adamjvr/kimchi-ethernet-lid/README.md

# kimchi-ethernet-lid
A simple lid for the GroupGets Kimchi Miro SBC that adds gigabit Ethernet in a compact package
