adamjvr/kimchi-ethernet-lid/PCB/NewOrderBom.ods

Reference | Quantity | MFR# | Digikey # | Notes
C16 | 1 | GRM155R61A475MEAAD | 490-14306-1-ND
C17 C18 | 2 | 04025A180GAT2A | 478-11762-1-ND
C21 | 1 | C0603C103KARACAUTO | 399-17960-1-ND
C1 C2 C3 C4 C5 C6 C7 C8 C10 C11 C12 C13 C14 C19 C20 | 15 | C0402C104K9PACTU | 399-3026-6-ND
C9 C15 | 2 | 0402ZD105KAT2A | 478-4596-1-ND
FB1 FB2 FB3 | 3 | MMZ1005S601CTD25 | 445-172793-1-ND
FB4 | 1 | FBMJ1608HM180NTR | 587-3251-1-ND
H1 H2 H3 H4 | 4 | Mechanical_MountingHole_Pad
J1 J2 | 2 | DF40HC(3.5)-60DS
J3 | 1 | ARJM11C7-502-AB-ER2-T | 535-14130-1-ND
R7 R8 R9 R10 R11 R12 R21 R22 R23 R24 R25 R26 | 12 | RC0402FR-0722RL | 311-22.0LRTR-ND
R1 R2 R3 R4 R15 R16 R20 R27 R28 | 9 | RC0402FR-071KL | 311-1.00KLRTR-ND
R5 R6 R13 R14 R17 R19 | 6 | RC0402FR-0710KL | 311-10.0KLRCT-ND
R18 | 1 | RMCF0402FT12K1 | RMCF0402FT12K1CT-ND
U1 | 1 | 24C32
U2 | 1 | TLV75712PDBVR | 296-50412-1-ND
U3 | 1 | KSZ9031RNXCC | KSZ9031RNXCC-ND | Out of Stock at Digikey, we went with this PHY because its proven in other designs our engineering team is familiar with
Y1 | 1 | ABM3-25.000MHZ-D2Y-T | 535-10645-1-ND
