adamjvr/kimchi-ethernet-lid/PCB/kimchi-ethernet-lid.kicad_pcb

## KiCad design PCB/kimchi-ethernet-lid.kicad_pcb (2021-06-15)

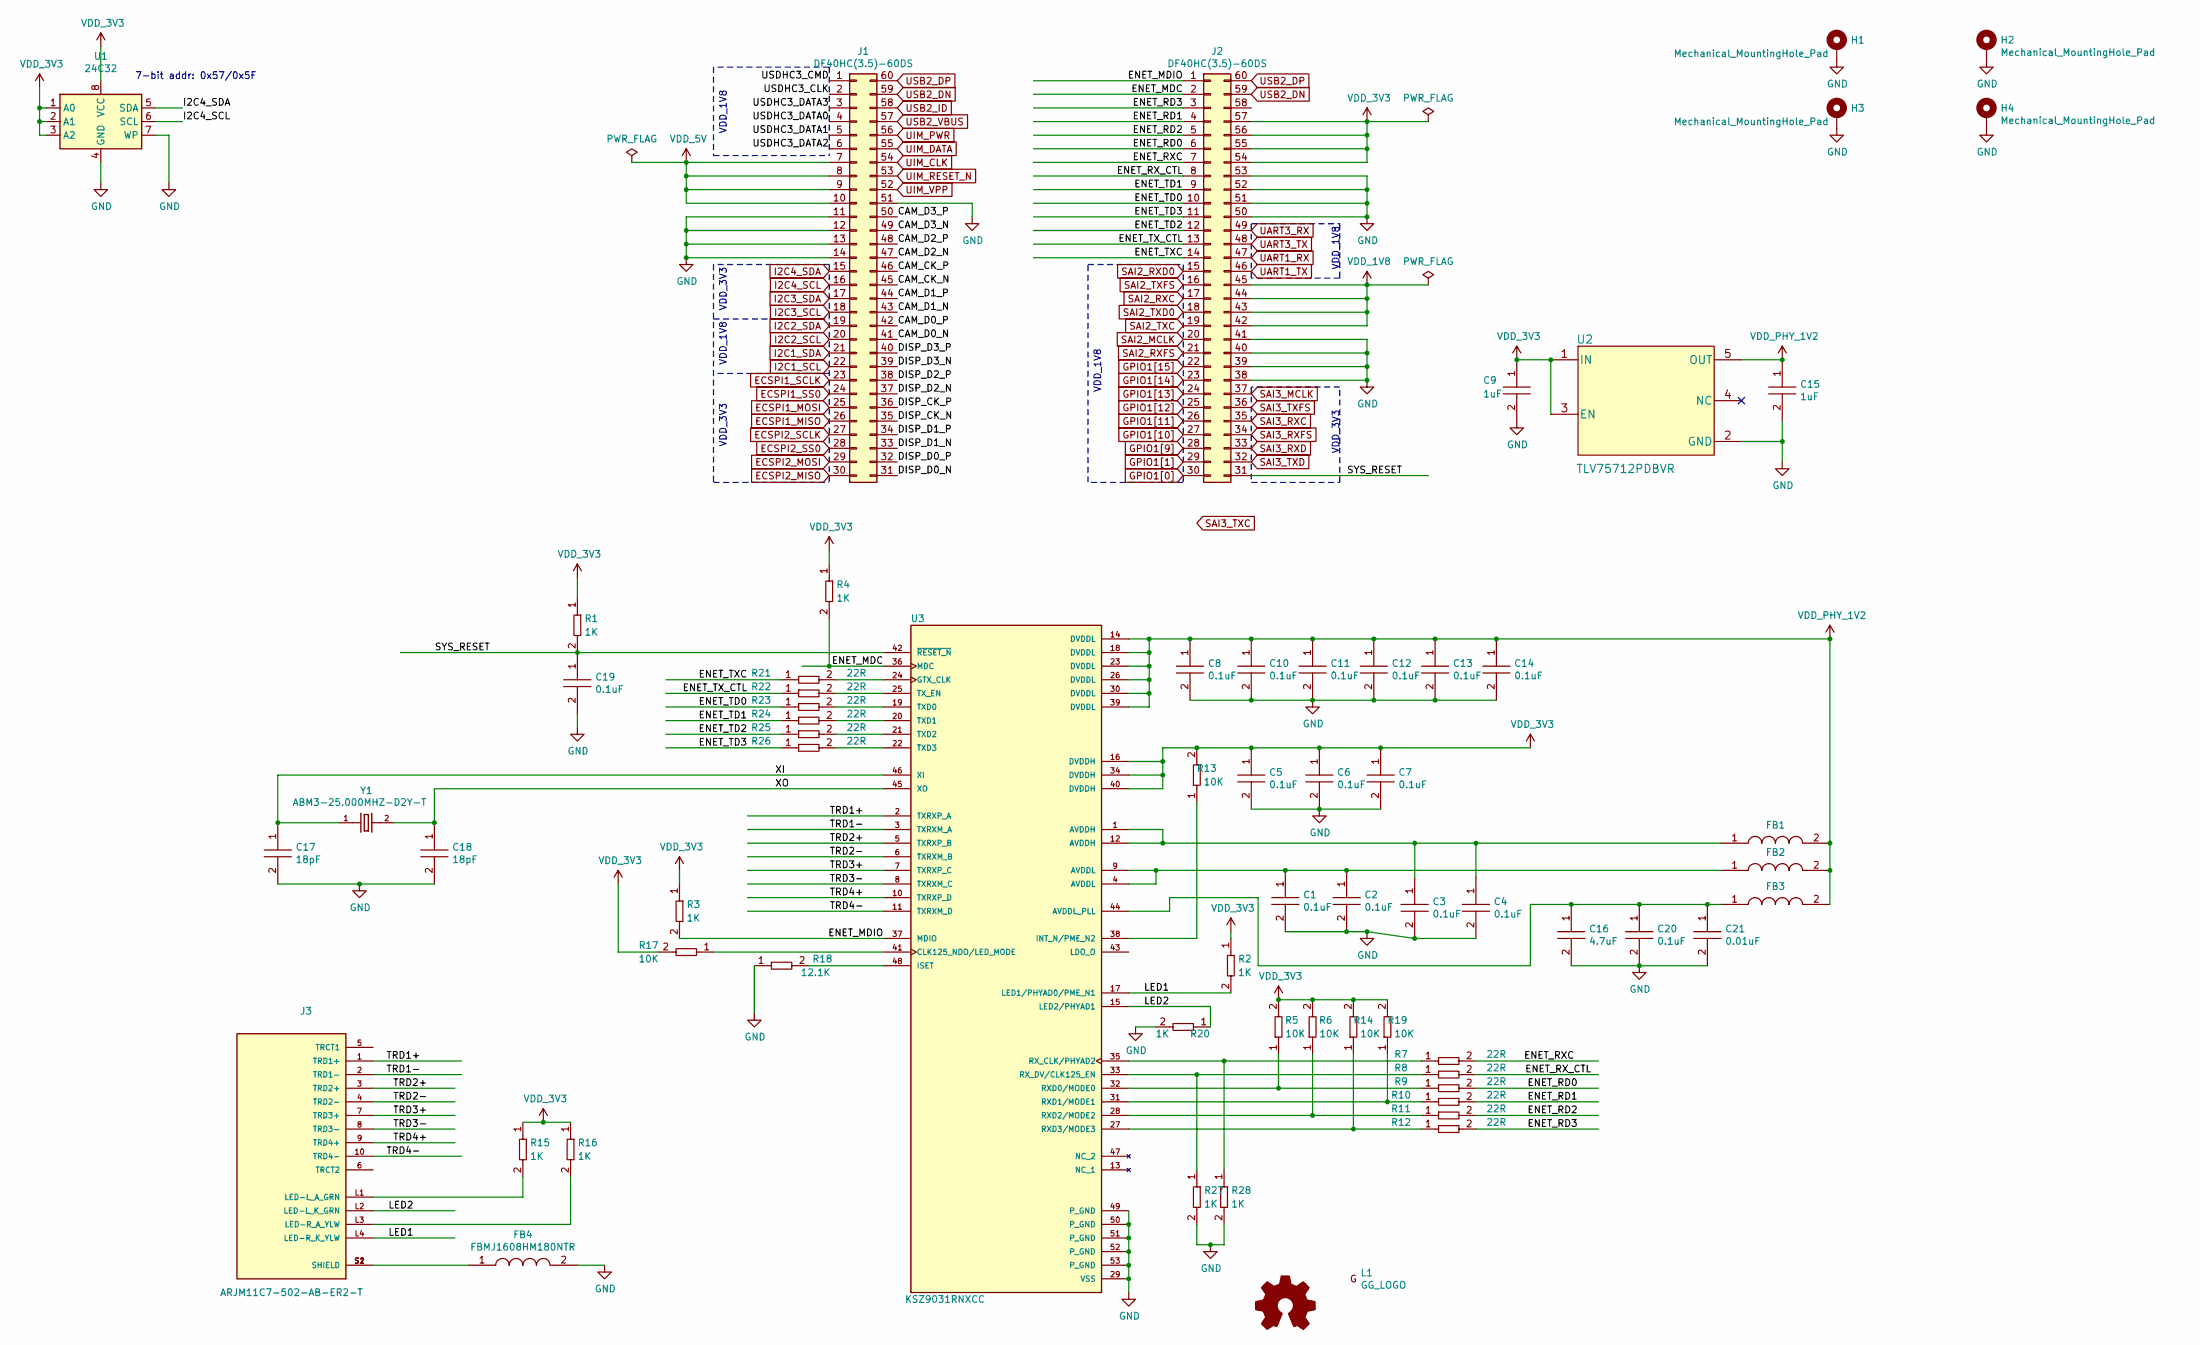
[picture p2: schematic kimchi-ethernet-lid.sch]

Parts:
C1, C2, C3, C4, C5, C6, C7, C8, C10, C11, C12, C13, C14, C19, C20: C0402C104K9PACTU; R0402; Tolerance 10%; Voltage 6.3V; MFR# C0402C104K9PACTU
C9, C15: 0402ZD105KAT2A; R0402; Tolerance 10%; Voltage 10V; MFR# 0402ZD105KAT2A
C16: GRM155R61A475MEAAD; C0402; Tolerance 20%; Voltage 10V; MFR# GRM155R61A475MEAAD
C17, C18: 04025A180GAT2A; C0402; Tolerance 2%; Voltage 50V; MFR# 04025A180GAT2A
C21: C0603C103KARACAUTO; C0603; Tolerance 10%; Voltage 250V; MFR# C0603C103KARACAUTO
FB1, FB2, FB3: MMZ1005S601CTD25; R0402; Tolerance *; Voltage *; MFR# MMZ1005S601CTD25
FB4: FBMJ1608HM180NTR; R0603; Tolerance *; Voltage *; MFR# FBMJ1608HM180NTR
H1, H2, H3, H4: Mechanical_MountingHole_Pad; MountingHole_3mm_Pad
J1, J2: DF40HC(3.5)-60DS
J3: ARJM11C7-502-AB-ER2-T; ABRACON_ARJM11C7-502-AB-ER2-T; PARTREV 04.22.2019
L1: GG_LOGO; groupgets_logo
LOGO1: Graphic_Logo_Open_Hardware_Small; OSHW-Logo_5.7x6mm_SilkScreen
R1, R2, R3, R4, R15, R16, R20, R27, R28: RC0402FR-071KL; R0402; Tolerance 1%; Voltage *; MFR# RC0402FR-071KL
R5, R6, R13, R14, R17, R19: RC0402FR-0710KL; R0402; Tolerance 1%; Voltage *; MFR# RC0402FR-0710KL
R7, R8, R9, R10, R11, R12, R21, R22, R23, R24, R25, R26: RC0402FR-0722RL; R0402; Tolerance 1%; Voltage *; MFR# RC0402FR-0722RL
R18: RMCF0402FT12K1; R0402; Tolerance 1%; Voltage *; MFR# RMCF0402FT12K1
U1: 24C32; DFN-8-1EP_3x2mm_P0.5mm_EP1.36x1.46mm; Part M24C32-FMC6TG
U2: TLV75712PDBVR
U3: KSZ9031RNXCC; QFN50P700X700X90-49N
Y1: ABM3-25.000MHZ-D2Y-T; XTAL500X320X130N

Connections:
/CAM_CK_N: J1.45
/CAM_CK_P: J1.46
/CAM_D0_N: J1.41
/CAM_D0_P: J1.42
/CAM_D1_N: J1.43
/CAM_D1_P: J1.44
/CAM_D2_N: J1.47
/CAM_D2_P: J1.48
/CAM_D3_N: J1.49
/CAM_D3_P: J1.50
/DISP_CK_N: J1.35
/DISP_CK_P: J1.36
/DISP_D0_N: J1.31
/DISP_D0_P: J1.32
/DISP_D1_N: J1.33
/DISP_D1_P: J1.34
/DISP_D2_N: J1.37
/DISP_D2_P: J1.38
/DISP_D3_N: J1.39
/DISP_D3_P: J1.40
/ENET_MDC: J2.2, R4.2, U3.36 (MDC)
/ENET_MDIO: J2.1, R3.2, U3.37 (MDIO); also elsewhere on the board
/ENET_RD0: J2.6, R9.2
/ENET_RD1: J2.4, R10.2
/ENET_RD2: J2.5, R11.2
/ENET_RD3: J2.3, R12.2
/ENET_RXC: J2.7, R7.2
/ENET_RX_CTL: J2.8, R8.2
/ENET_TD0: J2.10, R23.1
/ENET_TD1: J2.9, R24.1
/ENET_TD2: J2.12, R25.1
/ENET_TD3: J2.11, R26.1
/ENET_TXC: J2.14, R21.1
/ENET_TX_CTL: J2.13, R22.1
/LED1: J3.L4 (LED-R_K_YLW), R2.2, U3.17 (LED1/PHYAD0/PME_N1)
/LED2: J3.L2 (LED-L_K_GRN), R20.1, U3.15 (LED2/PHYAD1)
/SYS_RESET: C19.1, J2.31, R1.2, U3.42 (~RESET_N)
/TRD1+: J3.1 (TRD1+), U3.2 (TXRXP_A)
/TRD1-: J3.2 (TRD1-), U3.3 (TXRXM_A)
/TRD2+: J3.3 (TRD2+), U3.5 (TXRXP_B)
/TRD2-: J3.4 (TRD2-), U3.6 (TXRXM_B)
/TRD3+: J3.7 (TRD3+), U3.7 (TXRXP_C)
/TRD3-: J3.8 (TRD3-), U3.8 (TXRXM_C)
/TRD4+: J3.9 (TRD4+), U3.10 (TXRXP_D)
/TRD4-: J3.10 (TRD4-), U3.11 (TXRXM_D)
/USDHC3_CLK: J1.2
/USDHC3_CMD: J1.1
/USDHC3_DATA0: J1.4
/USDHC3_DATA1: J1.5
/USDHC3_DATA2: J1.6
/USDHC3_DATA3: J1.3
/XI: C17.1, U3.46 (XI), Y1.1
/XO: C18.1, U3.45 (XO), Y1.2
ECSPI1_MISO: J1.26
ECSPI1_MOSI: J1.25
ECSPI1_SCLK: J1.23
ECSPI1_SS0: J1.24
ECSPI2_MISO: J1.30
ECSPI2_MOSI: J1.29
ECSPI2_SCLK: J1.27
ECSPI2_SS0: J1.28
GND: C1.2, C2.2, C3.2, C4.2, C5.2, C6.2, C7.2, C8.2, C9.2, C10.2, C11.2, C12.2, C13.2, C14.2, C15.2, C16.2, C17.2, C18.2, C19.2, C20.2, C21.2, FB4.2, H1.1, H2.1, H3.1, H4.1, J1.11, J1.12, J1.13, J1.14, J1.51, J2.38, J2.39, J2.40, J2.41, J2.50, J2.51, J2.52, J2.53, R18.1, R20.2, R27.2, R28.2, U1.4 (GND), U1.7 (WP), U2.2 (GND), U3.29 (VSS), U3.49 (P_GND), U3.50 (P_GND), U3.51 (P_GND), U3.52 (P_GND), U3.53 (P_GND)
GPIO1[0]: J2.30
GPIO1[1]: J2.29
GPIO1[9]: J2.28
GPIO1[10]: J2.27
GPIO1[11]: J2.26
GPIO1[12]: J2.25
GPIO1[13]: J2.24
GPIO1[14]: J2.23
GPIO1[15]: J2.22
I2C1_SCL: J1.22
I2C1_SDA: J1.21
I2C2_SCL: J1.20
I2C2_SDA: J1.19
I2C3_SCL: J1.18
I2C3_SDA: J1.17
I2C4_SCL: J1.16, U1.6 (SCL)
I2C4_SDA: J1.15, U1.5 (SDA)
unnamed: C1.1, C2.1, FB2.1, U3.4 (AVDDL), U3.9 (AVDDL)
unnamed: C3.1, C4.1, FB1.1, U3.1 (AVDDH), U3.12 (AVDDH)
unnamed: C16.1, C20.1, C21.1, FB3.1, U3.44 (AVDDL_PLL)
unnamed: FB4.1, J3.S1 (SHIELD), J3.S2 (SHIELD)
unnamed: J3.L1 (LED-L_A_GRN), R15.2
unnamed: J3.L3 (LED-R_A_YLW), R16.2
unnamed: R5.1, R9.1, U3.32 (RXD0/MODE0)
unnamed: R10.1, R19.1, U3.31 (RXD1/MODE1)
unnamed: R6.1, R11.1, U3.28 (RXD2/MODE2)
unnamed: R12.1, R14.1, U3.27 (RXD3/MODE3)
unnamed: R13.1, U3.38 (INT_N/PME_N2)
unnamed: R17.1, U3.41 (CLK125_NDO/LED_MODE)
unnamed: R18.2, U3.48 (ISET)
unnamed: R21.2, U3.24 (GTX_CLK)
unnamed: R22.2, U3.25 (TX_EN)
unnamed: R23.2, U3.19 (TXD0)
unnamed: R24.2, U3.20 (TXD1)
unnamed: R25.2, U3.21 (TXD2)
unnamed: R26.2, U3.22 (TXD3)
unnamed: R8.1, R27.1, U3.33 (RX_DV/CLK125_EN)
unnamed: R7.1, R28.1, U3.35 (RX_CLK/PHYAD2)
SAI2_MCLK: J2.20
SAI2_RXC: J2.17
SAI2_RXD0: J2.15
SAI2_RXFS: J2.21
SAI2_TXC: J2.19
SAI2_TXD0: J2.18
SAI2_TXFS: J2.16
SAI3_MCLK: J2.37
SAI3_RXC: J2.35
SAI3_RXD: J2.33
SAI3_RXFS: J2.34
SAI3_TXD: J2.32
SAI3_TXFS: J2.36
UART1_RX: J2.47
UART1_TX: J2.46
UART3_RX: J2.49
UART3_TX: J2.48
UIM_CLK: J1.54
UIM_DATA: J1.55
UIM_PWR: J1.56
UIM_RESET_N: J1.53
UIM_VPP: J1.52
USB2_DN: J1.59, J2.59
USB2_DP: J1.60, J2.60
USB2_ID: J1.58
USB2_VBUS: J1.57
VDD_1V8: J2.42, J2.43, J2.44, J2.45
VDD_3V3: C5.1, C6.1, C7.1, C9.1, J2.54, J2.55, J2.56, J2.57, R1.1, R2.1, R3.1, R4.1, R5.2, R6.2, R13.2, R14.2, R15.1, R16.1, R17.2, R19.2, U1.1 (A0), U1.2 (A1), U1.3 (A2), U1.8 (VCC), U2.1 (IN), U2.3 (EN), U3.16 (DVDDH), U3.34 (DVDDH), U3.40 (DVDDH); also elsewhere on the board
VDD_5V: J1.7, J1.8, J1.9, J1.10
VDD_PHY_1V2: C8.1, C10.1, C11.1, C12.1, C13.1, C14.1, C15.1, FB1.2, FB2.2, FB3.2, U2.5 (OUT), U3.14 (DVDDL), U3.18 (DVDDL), U3.23 (DVDDL), U3.26 (DVDDL), U3.30 (DVDDL), U3.39 (DVDDL)

Notes on the sheet:
7-bit addr: 0x57/0x5F
VDD_1V8
VDD_3V3

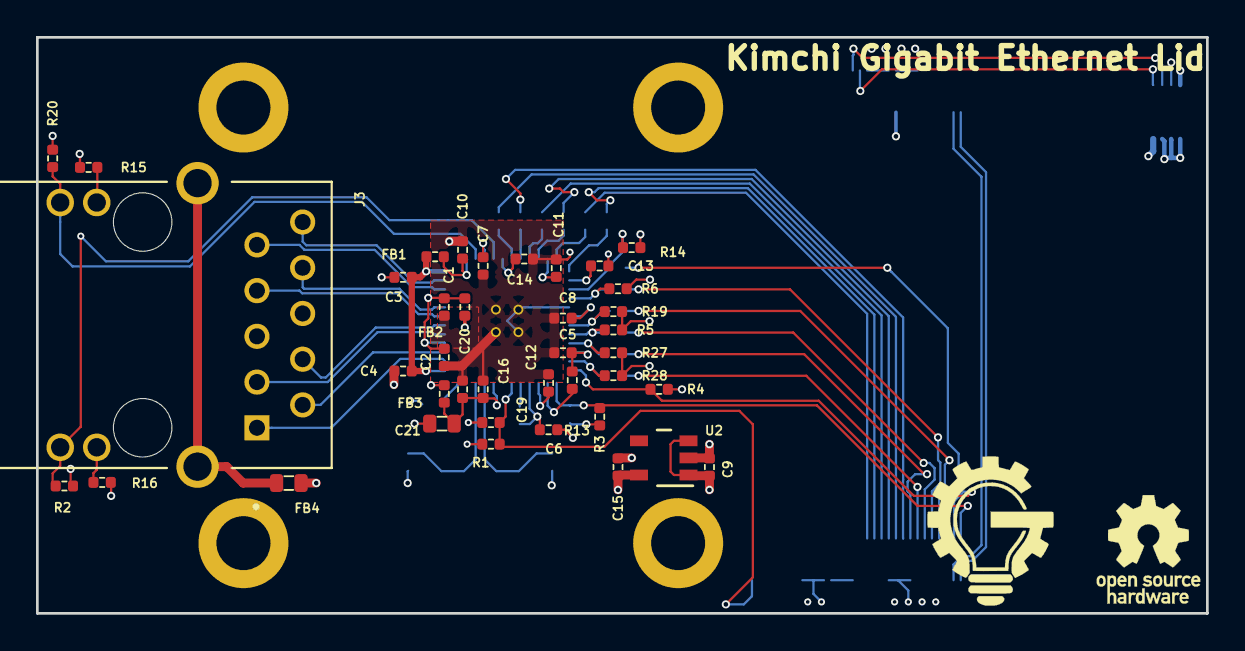
[picture p3: board kimchi-ethernet-lid.kicad_pcb from above]

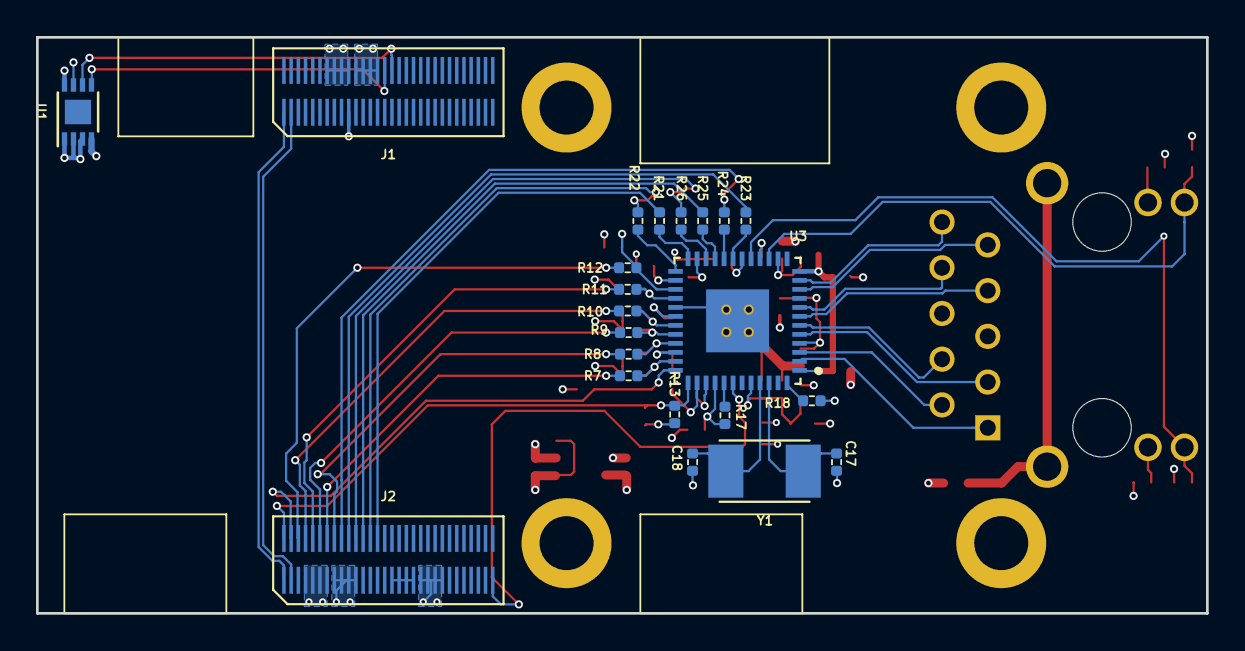
[picture p4: board kimchi-ethernet-lid.kicad_pcb from below]

Board: 4 copper layers, 65.0 x 32.0 mm, 67 parts (22 on the bottom side), 57 nets.

Other parts of the board:
R13#2: RC0402FR-074K7L; R0402

Their connections:
/ENET_MDIO: R13#2.2; also elsewhere on the board
VDD_3V3: R13#2.1; also elsewhere on the board
