adamjvr/kimchi-ethernet-lid/(commit log)

2021-04-27 Template Project Import
    Imported Template project form the GroupGets repository for Kimchi lid templates. Changed file names over to create project for ethernet-lid. work in progress.
    [kimchi-ethernet-lid.kicad_pcb, kimchi-ethernet-lid.sch]
2021-04-30 Libraries, Schematic Capture, Part Placement, Lauout
    Created and added all realted components. Completed schematic capture. Part placement all bu down, layout in progress since schematic capture.
    Had to change out mag jacks a lot to find one that would fit the design
    [kimchi-ethernet-lid.kicad_pcb, kimchi-ethernet-lid.sch]
2021-04-30 Change in design
    Swapped orientation of PHY and position of ethernet connector, moving computers
    [kimchi-ethernet-lid.kicad_pcb]
2021-04-30 small schematic tweak that didn't get synced
    d
    [kimchi-ethernet-lid.sch]
2021-05-03 Route Complete
    RMGII signals routed to kimchi headers, ENET diff pairs tuned routed to connector. Power distribution scheme designed and implemented. First pass of route done, Further analysis need for RGMII interface trace length tuning
    [kimchi-ethernet-lid.kicad_pcb, kimchi-ethernet-lid.sch]
2021-05-04 Memory Module
    Memory module moved, USB to PCIe passthrough added. BOM created in libreoffice format, CSV from component fields also generated.
    [Order_BOM.ods, kimchi-ethernet-lid.kicad_pcb, kimchi-ethernet-lid.sch]
2021-06-02 Pullups
    Pullup resistors added to RGMII interface setup on boot.
    [kimchi-ethernet-lid.kicad_pcb, kimchi-ethernet-lid.sch]
2021-06-03 Silkscreen Tweak and BOM
    Tweaked silkscreen text size and created order BOM
    [NewOrderBom.ods, Order_BOM.ods, kimchi-ethernet-lid.kicad_pcb]
2021-06-15 DRC and Sys_Reset
    Fixed some small DRC violations. zeroed out soldermask settings so that fab can decide their own. Tied SYS_RESET signal to muxable GPIO pin on Kimchi header.
    [kimchi-ethernet-lid.kicad_pcb, kimchi-ethernet-lid.sch]
